kacperoreszczuk/lums_stepper/case/obudowa.PNG

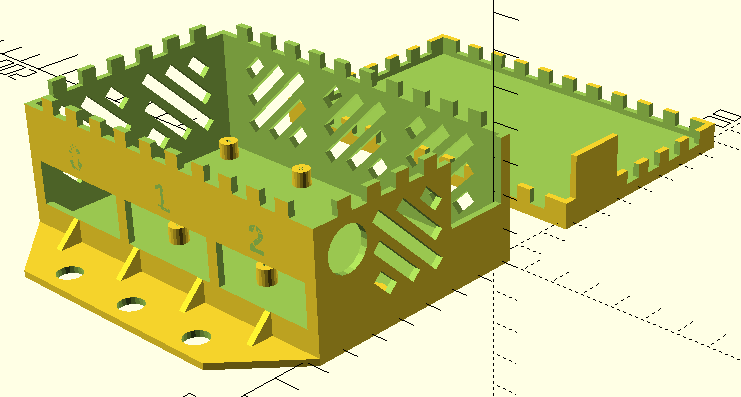
case/obudowa.PNG
