kacperoreszczuk/lums_stepper/PCB/image_3D.PNG

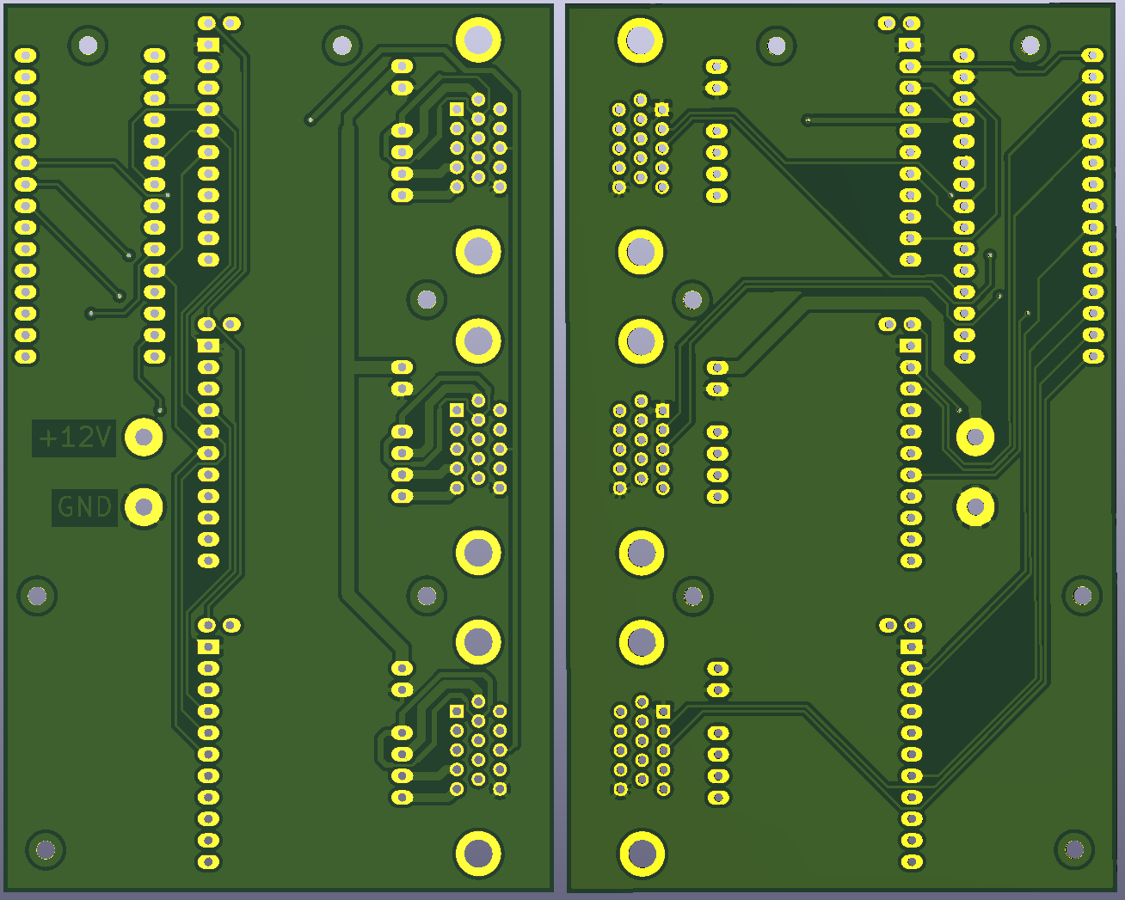
PCB/image_3D.PNG
