kacperoreszczuk/lums_stepper/case/obudowa.stl

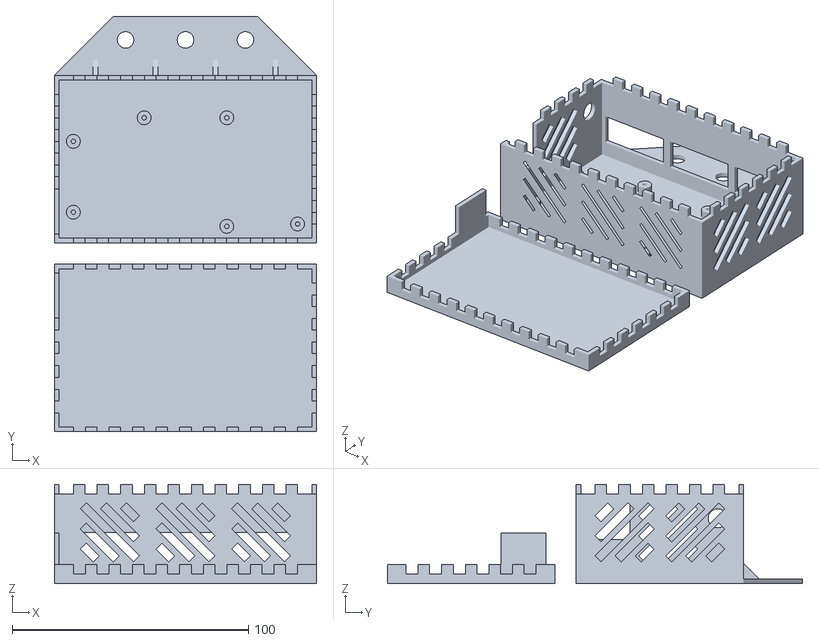
[picture p9: CAD file, 2020-02-18]
case/obudowa.stl
111.0 x 176.0 x 42.0
