kacperoreszczuk/lums_stepper/schematics.pdf

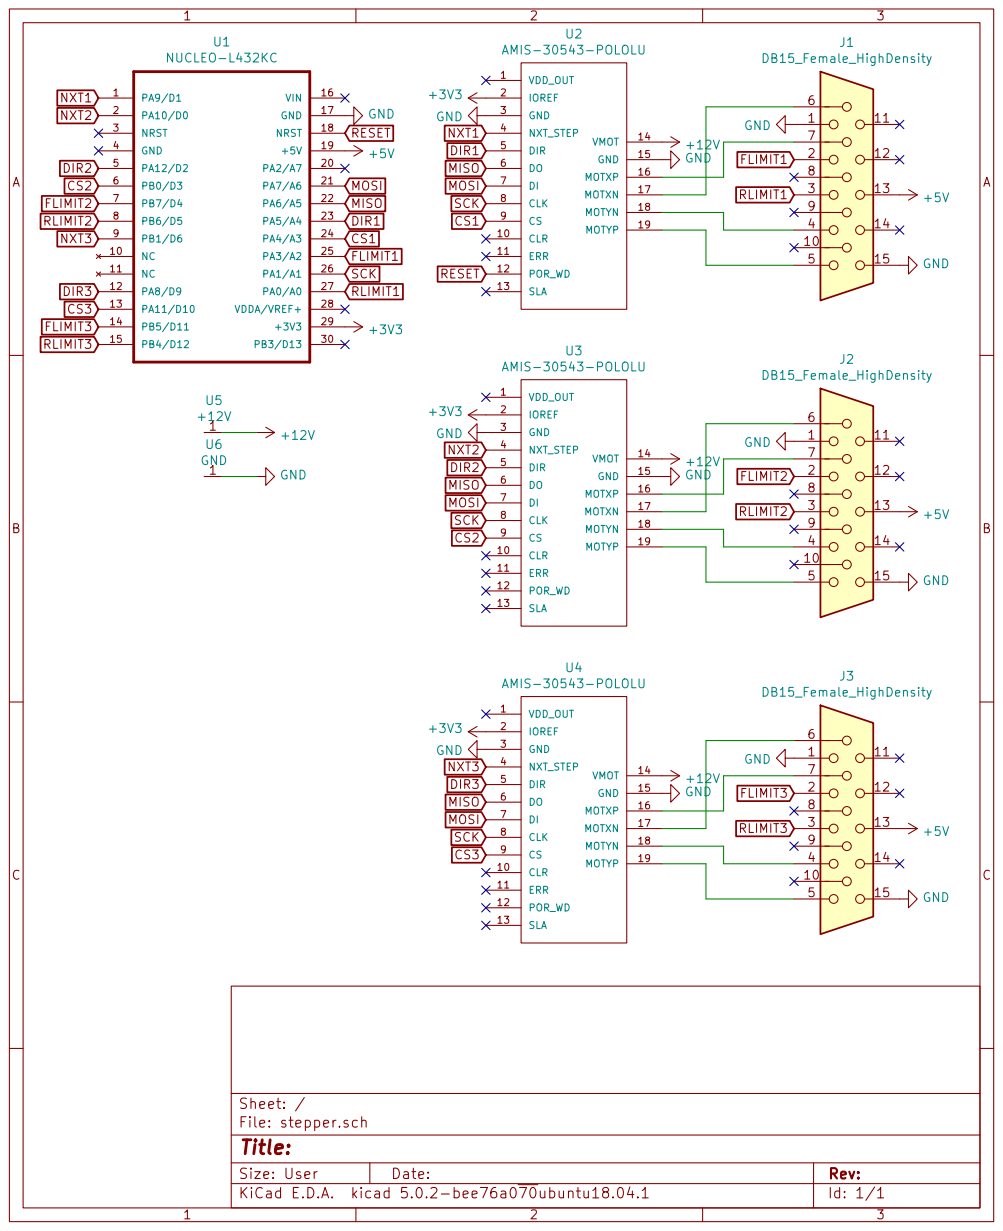
[picture p10: page 1]

File: stepper.sch Sheet: /
