kacperoreszczuk/lums_stepper/PCB/PCB_project/stepper.kicad_pcb

## KiCad design PCB/PCB_project/stepper.kicad_pcb (2020-07-30)

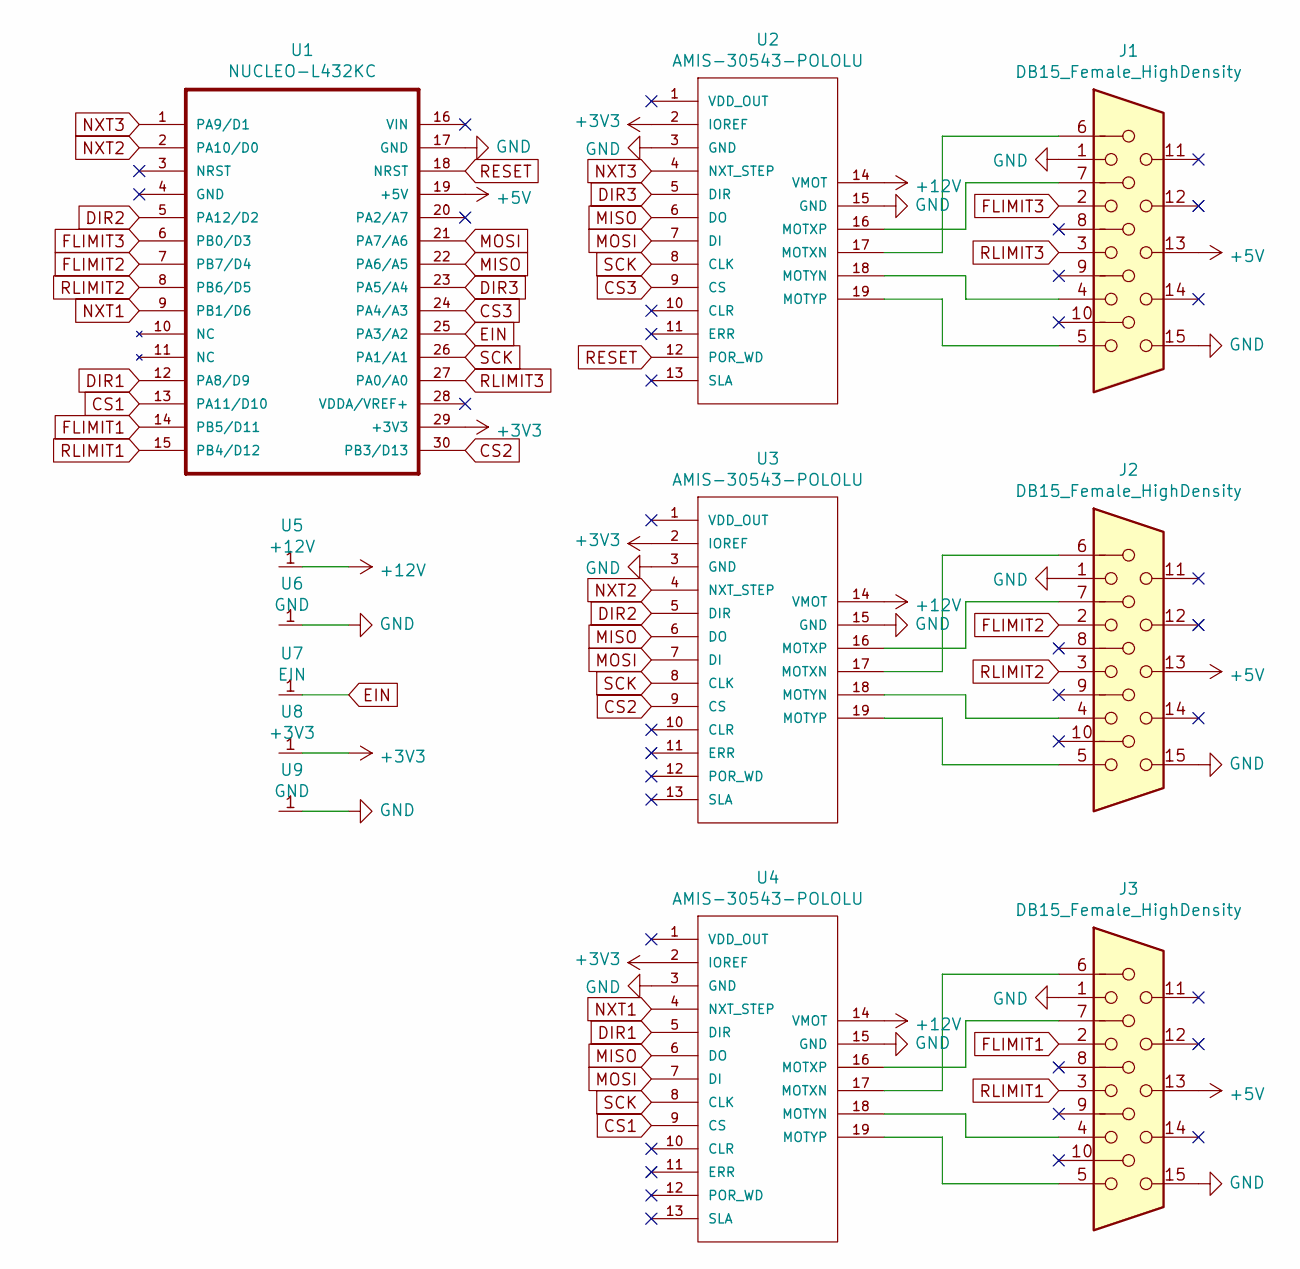
[picture p11: schematic stepper.sch]

Parts:
J1, J2, J3: DB15_Female_HighDensity; DSUB-15-HD_Male_Horizontal_Pitch2.29x2.54mm_EdgePinOffset9.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
U1: NUCLEO-L432KC
U2, U3, U4: AMIS-30543-POLOLU
U5: +12V; SolderWirePad_single_2mmDrill
U6: GND; SolderWirePad_single_2mmDrill
U7: EIN; TestPoint_Plated_Hole_D2.0mm
U8: +3V3; TestPoint_Plated_Hole_D2.0mm
U9: GND; TestPoint_Plated_Hole_D2.0mm

Connections:
+3V3: U1.29 (+3V3), U2.2 (IOREF), U3.2 (IOREF), U4.2 (IOREF), U8.1
+5V: J1.13, J2.13, J3.13, U1.19 (+5V)
+12V: U2.14 (VMOT), U3.14 (VMOT), U4.14 (VMOT), U5.1
CS1: U1.13 (PA11/D10), U4.9 (CS)
CS2: U1.30 (PB3/D13), U3.9 (CS)
CS3: U1.24 (PA4/A3), U2.9 (CS)
DIR1: U1.12 (PA8/D9), U4.5 (DIR)
DIR2: U1.5 (PA12/D2), U3.5 (DIR)
DIR3: U1.23 (PA5/A4), U2.5 (DIR)
EIN: U1.25 (PA3/A2), U7.1
FLIMIT1: J3.2, U1.14 (PB5/D11)
FLIMIT2: J2.2, U1.7 (PB7/D4)
FLIMIT3: J1.2, U1.6 (PB0/D3)
GND: J1.1, J1.15, J2.1, J2.15, J3.1, J3.15, U1.17 (GND), U2.3 (GND), U2.15 (GND), U3.3 (GND), U3.15 (GND), U4.3 (GND), U4.15 (GND), U6.1, U9.1
MISO: U1.22 (PA6/A5), U2.6 (DO), U3.6 (DO), U4.6 (DO)
MOSI: U1.21 (PA7/A6), U2.7 (DI), U3.7 (DI), U4.7 (DI)
NXT1: U1.9 (PB1/D6), U4.4 (NXT_STEP)
NXT2: U1.2 (PA10/D0), U3.4 (NXT_STEP)
NXT3: U1.1 (PA9/D1), U2.4 (NXT_STEP)
unnamed: J1.4, U2.18 (MOTYN)
unnamed: J1.5, U2.19 (MOTYP)
unnamed: J1.6, U2.17 (MOTXN)
unnamed: J1.7, U2.16 (MOTXP)
unnamed: J2.4, U3.18 (MOTYN)
unnamed: J2.5, U3.19 (MOTYP)
unnamed: J2.6, U3.17 (MOTXN)
unnamed: J2.7, U3.16 (MOTXP)
unnamed: J3.4, U4.18 (MOTYN)
unnamed: J3.5, U4.19 (MOTYP)
unnamed: J3.6, U4.17 (MOTXN)
unnamed: J3.7, U4.16 (MOTXP)
RESET: U1.18 (NRST), U2.12 (POR_WD)
RLIMIT1: J3.3, U1.15 (PB4/D12)
RLIMIT2: J2.3, U1.8 (PB6/D5)
RLIMIT3: J1.3, U1.27 (PA0/A0)
SCK: U1.26 (PA1/A1), U2.8 (CLK), U3.8 (CLK), U4.8 (CLK)

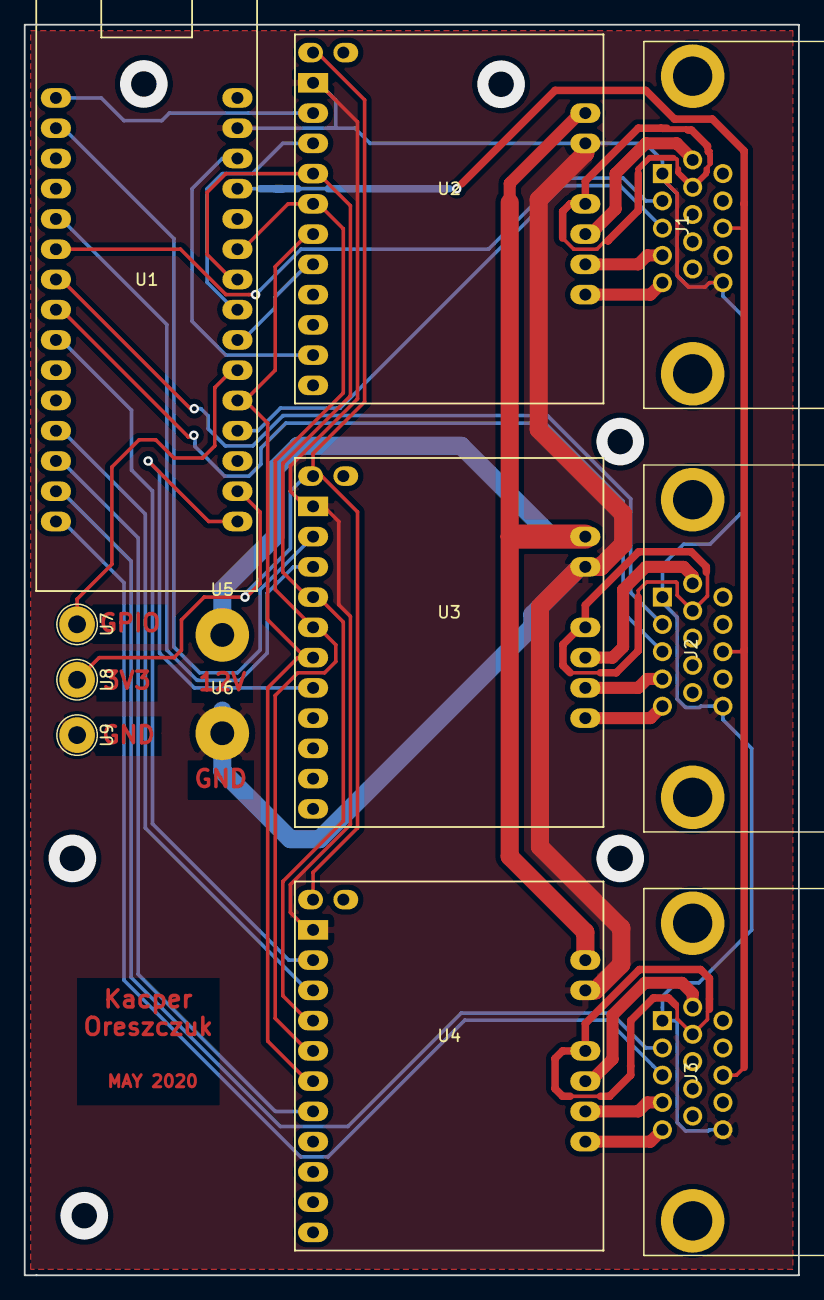
[picture p12: board stepper.kicad_pcb from above]

Board: 2 copper layers, 65.0 x 105.0 mm, 12 parts (0 on the bottom side), 36 nets.
