kacperoreszczuk/lums_stepper/firmware/Inc/main.h

#define RLIMIT3_Pin GPIO_PIN_0
#define RLIMIT3_GPIO_Port GPIOA
#define VCP_TX_Pin GPIO_PIN_2
#define VCP_TX_GPIO_Port GPIOA
#define EIO_Pin GPIO_PIN_3
#define EIO_GPIO_Port GPIOA
#define CS3_Pin GPIO_PIN_4
#define CS3_GPIO_Port GPIOA
#define DIR3_Pin GPIO_PIN_5
#define DIR3_GPIO_Port GPIOA
#define FLIMIT3_Pin GPIO_PIN_0
#define FLIMIT3_GPIO_Port GPIOB
#define NXT1_Pin GPIO_PIN_1
#define NXT1_GPIO_Port GPIOB
#define DIR1_Pin GPIO_PIN_8
#define DIR1_GPIO_Port GPIOA
#define NXT3_Pin GPIO_PIN_9
#define NXT3_GPIO_Port GPIOA
#define NXT2_Pin GPIO_PIN_10
#define NXT2_GPIO_Port GPIOA
#define CS1_Pin GPIO_PIN_11
#define CS1_GPIO_Port GPIOA
#define DIR2_Pin GPIO_PIN_12
#define DIR2_GPIO_Port GPIOA
#define VCP_RX_Pin GPIO_PIN_15
#define VCP_RX_GPIO_Port GPIOA
#define CS2_Pin GPIO_PIN_3
#define CS2_GPIO_Port GPIOB
#define RLIMIT1_Pin GPIO_PIN_4
#define RLIMIT1_GPIO_Port GPIOB
#define FLIMIT1_Pin GPIO_PIN_5
#define FLIMIT1_GPIO_Port GPIOB
#define RLIMIT2_Pin GPIO_PIN_6
#define RLIMIT2_GPIO_Port GPIOB
#define FLIMIT2_Pin GPIO_PIN_7
#define FLIMIT2_GPIO_Port GPIOB
