kacperoreszczuk/lums_stepper/firmware/Src/main.c

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

/* Includes ------------------------------------------------------------------*/
#include "main.h"

/* USER CODE BEGIN Includes */
#include "usrMain.h"
#include "handles.h"
/* USER CODE END Includes */

SPI_HandleTypeDef hspi1;

TIM_HandleTypeDef htim1;
TIM_HandleTypeDef htim2;
TIM_HandleTypeDef htim6;
TIM_HandleTypeDef htim7;

UART_HandleTypeDef huart2;
DMA_HandleTypeDef hdma_usart2_rx;
DMA_HandleTypeDef hdma_usart2_tx;

/* USER CODE BEGIN PV */

uint8_t tx_busy = 0;
uint8_t uart_receive_buffer[10];
//uint8_t uart_buffer[UART_BUFFER_SIZE];
uint32_t uart_count;
uint32_t ticks;
SPI_HandleTypeDef *spi1Handle;
UART_HandleTypeDef *uart2Handle;
/* USER CODE END PV */

void SystemClock_Config(void);
static void MX_GPIO_Init(void);
static void MX_DMA_Init(void);
static void MX_SPI1_Init(void);
static void MX_USART2_UART_Init(void);
static void MX_TIM1_Init(void);
static void MX_TIM2_Init(void);
static void MX_TIM7_Init(void);
static void MX_TIM6_Init(void);
/* USER CODE BEGIN PFP */
void HAL_UART_RxCpltCallback(UART_HandleTypeDef *huart) {
  __HAL_UART_SEND_REQ(huart, UART_RXDATA_FLUSH_REQUEST);
  uart_byte_received(uart_receive_buffer[0]);
}

void HAL_UART_TxCpltCallback(UART_HandleTypeDef *huart) {
  tx_cplt();
}

void HAL_TIM_PeriodElapsedCallback(TIM_HandleTypeDef *htim)
{
  if (htim->Instance == htim1.Instance)
    nxt_tick();
  else if (htim->Instance == htim6.Instance)
    limit_switch_tick(); // TODO: to be triggered by UART Rx interrupt, but with lower priority
  else if (htim->Instance == htim7.Instance)
    uart_analyse_buffer(); // TODO: to be triggered by UART Rx interrupt, but with lower priority
  else if (htim->Instance == htim2.Instance)
    control_tick();
}
/* USER CODE END PFP */

/**
  * @brief  The application entry point.
  * @retval int
  */
int main(void)
{
  /* MCU Configuration--------------------------------------------------------*/

  /* Reset of all peripherals, Initializes the Flash interface and the Systick. */
  HAL_Init();

  /* Configure the system clock */
  SystemClock_Config();

  /* Initialize all configured peripherals */
  MX_GPIO_Init();
  MX_DMA_Init();
  MX_SPI1_Init();
  MX_USART2_UART_Init();
  MX_TIM1_Init();
  MX_TIM2_Init();
  MX_TIM7_Init();
  MX_TIM6_Init();
  /* USER CODE BEGIN 2 */

  HAL_TIM_Base_Start_IT(&htim6); 
  HAL_TIM_Base_Start_IT(&htim7); // other timers are initialised in usrMain() after driver initialisation
  __HAL_SPI_ENABLE(&hspi1);
  HAL_UART_Receive_DMA(&huart2, uart_receive_buffer, 1);

  /* USER CODE END 2 */

  /* Infinite loop */
  /* USER CODE BEGIN WHILE */

  usrMain();

  while (1)
  {

    /* USER CODE END WHILE */

    /* USER CODE BEGIN 3 */

  }
  /* USER CODE END 3 */
}

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
