kacperoreszczuk/lums_stepper/firmware/Inc/usrMain.h

#ifndef USR_MAIN_H_INCLUDED
#define USR_MAIN_H_INCLUDED

#include "stm32l4xx_hal.h"

void nxt_tick();
void control_tick();
void limit_switch_tick();
void uart_byte_received(uint8_t byte);
void uart_analyse_buffer();
void tick_counter();
void tx_cplt();
void check_tx_buffer();
void uart_transmit(uint8_t *data, uint16_t len);
int usrMain();

#endif /* __MAIN_H */
