kacperoreszczuk/lums_stepper/(commit log)

2019-07-04 Init commit
    [stepper.kicad_pcb, stepper.sch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]
2019-07-04 3D model for case added
    [obudowa.scad]
2019-09-23 Support for different limit switches, axis reversing, homing offset, code refactoring and optimisation, pin swap (not updated in PCB project!!).
    [handles.h, main.c, main.h, servos.ioc, usrMain.c]
2019-10-06 Non-blocking UART TX and real time RX parsing. NXT pin cloning to external output. Bugfix for homing for rotational stages.
    [main.c, usrMain.c]
2020-02-18 Firmware update - software filtering of limit switches
2020-02-18 updated case model files
    [obudowa.scad, obudowa.stl]
2020-02-18 PCP updated after pin swap
    [stepper.kicad_pcb, stepper.sch]
2020-07-30 Adaptatations in pinout for future switch panel
    [stepper.kicad_pcb, stepper.sch]
2022-08-08 Homing now possible also to the front limit switch. Change in id encoding in preparation to automatic preparation of binaries for different nodes
2023-01-17 fixed slightly wrong time step constant causing 2% incorrect speed/time calibration
    [obudowa.scad]
