kacperoreszczuk/lums_stepper/(notices)

Notices in the files:
firmware/Inc/main.h:
COPYRIGHT(c) 2019 STMicroelectronics
(C) COPYRIGHT STMicroelectronics *****END OF FILE
